amarburg/mascot_project_management/block_diagrams/Visio-IRD_Zed_Dry_Prototype_Block_Diagram.pdf

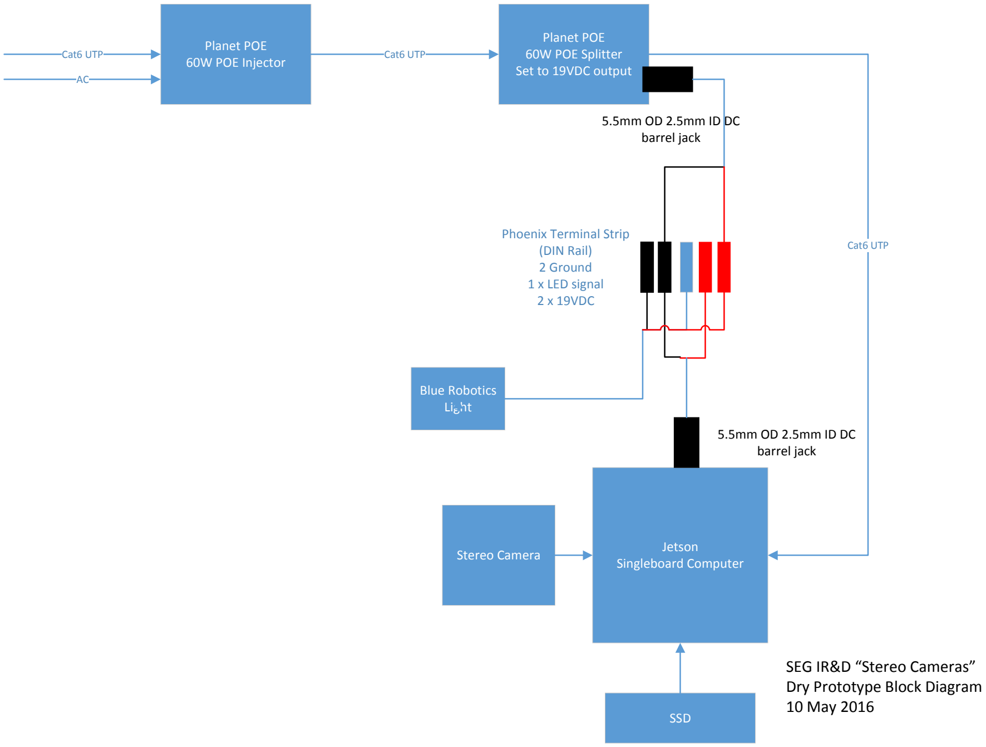
[picture p2: figure]
SEG IR&D “Stereo Cameras” Dry Prototype Block Diagram 10 May 2016; Planet POE 60W POE Injector; Planet POE 60W POE Splitter Set to 19VDC output; Cat6 UTP; Phoenix Terminal Strip (DIN Rail) 2 Ground 1 x LED signal 2 x 19VDC; 5.5mm OD 2.5mm ID DC barrel jack; Jetson Singleboard Computer; SSD; Stereo Camera; Blue Robotics Light
