amarburg/mascot_project_management/images/box_POE-171S.jpg

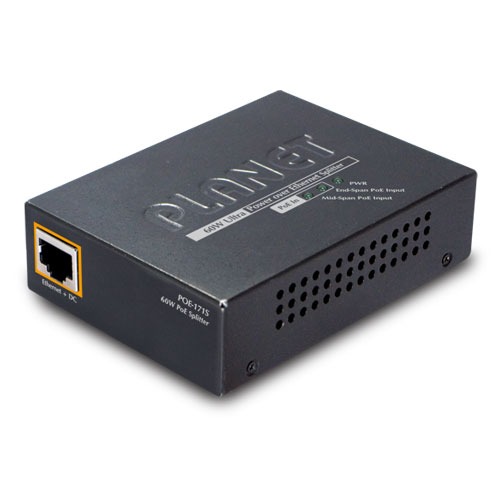
images/box_POE-171S.jpg
