amarburg/mascot_project_management/images/box_POE-172.jpg

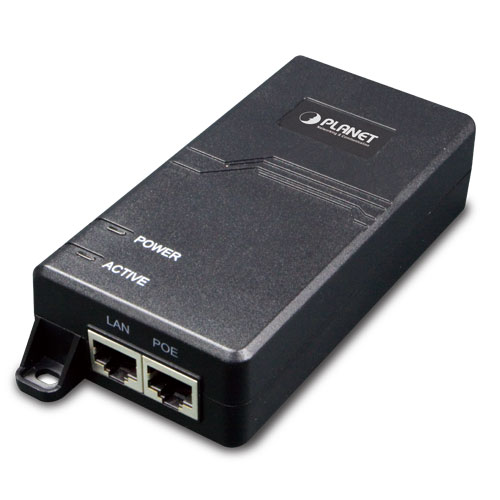
images/box_POE-172.jpg
