amarburg/mascot_project_management/images/DSC_0268.JPG

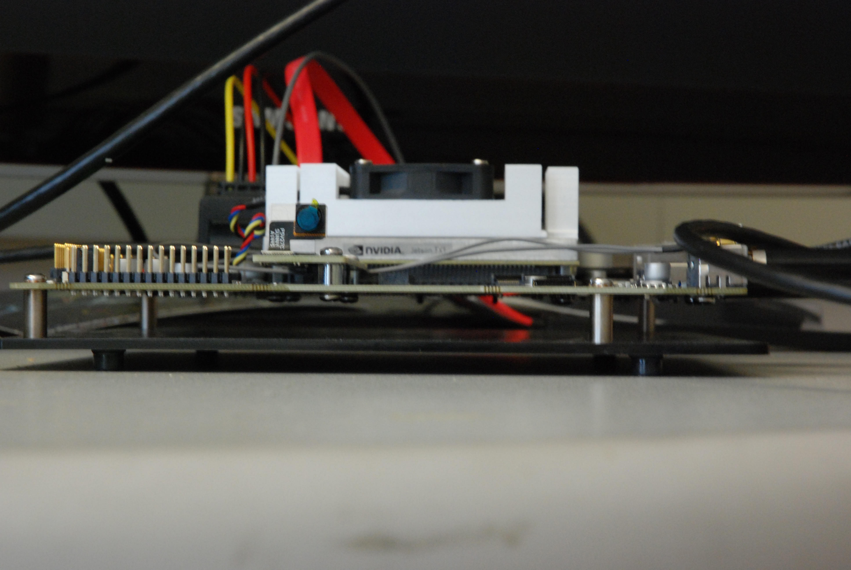
images/DSC_0268.JPG
