amarburg/mascot_project_management/images/DSC_0270.JPG

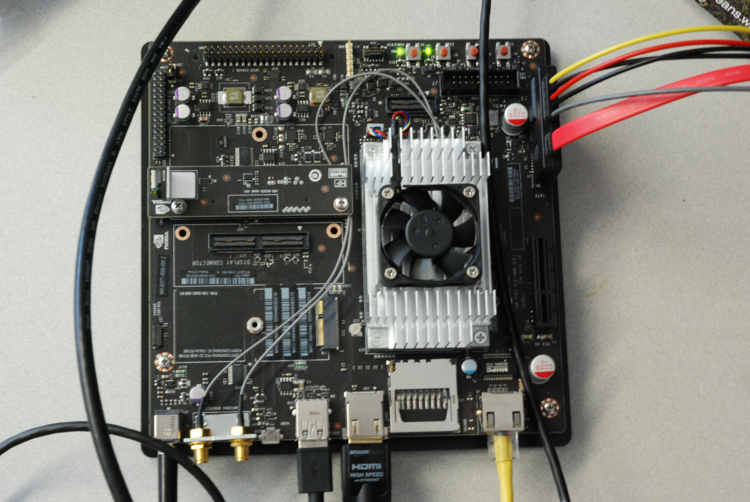
images/DSC_0270.JPG
