amarburg/mascot_project_management/images/Image-1.png

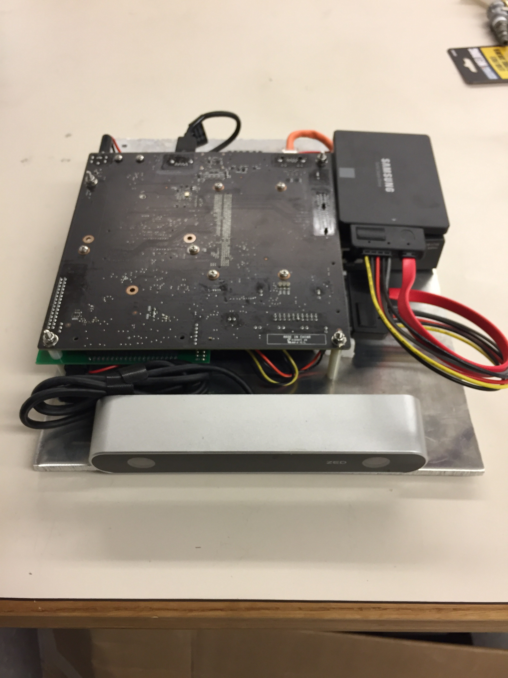
images/Image-1.png
