amarburg/mascot_project_management/images/Image-2.png

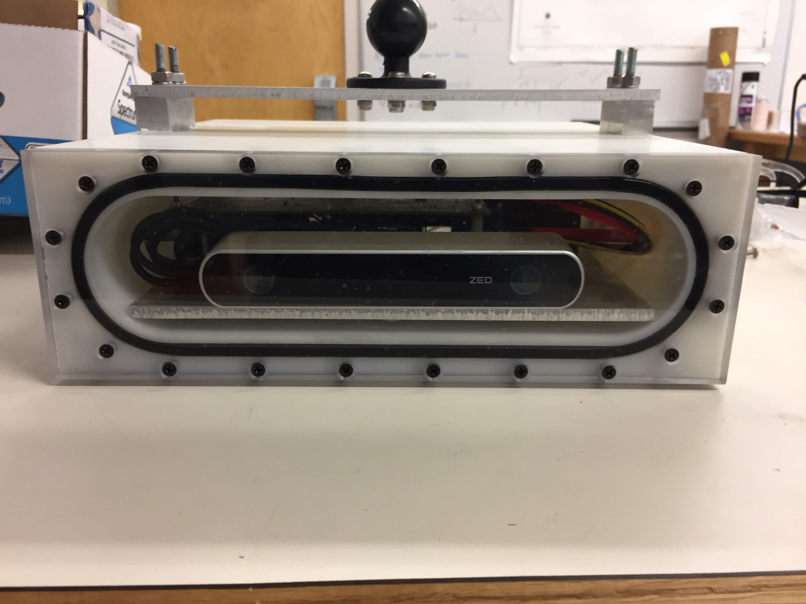
images/Image-2.png
