amarburg/mascot_project_management/images/Image.png

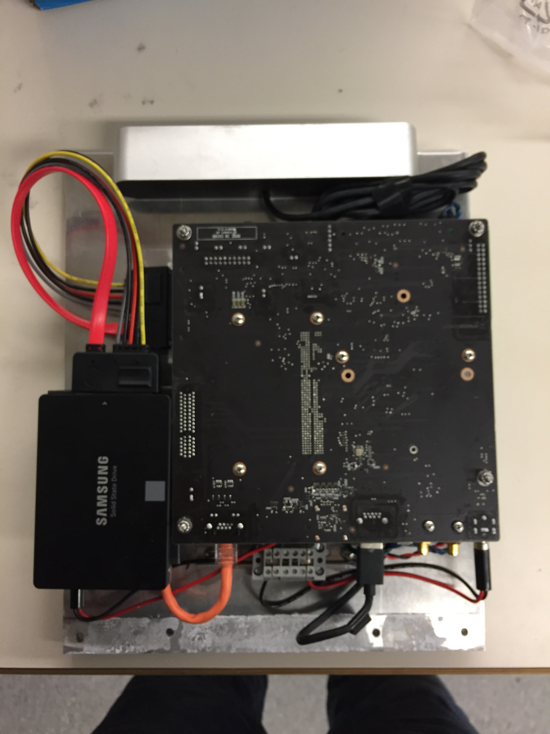
images/Image.png
