amarburg/mascot_project_management/images/IMG_0014.JPG

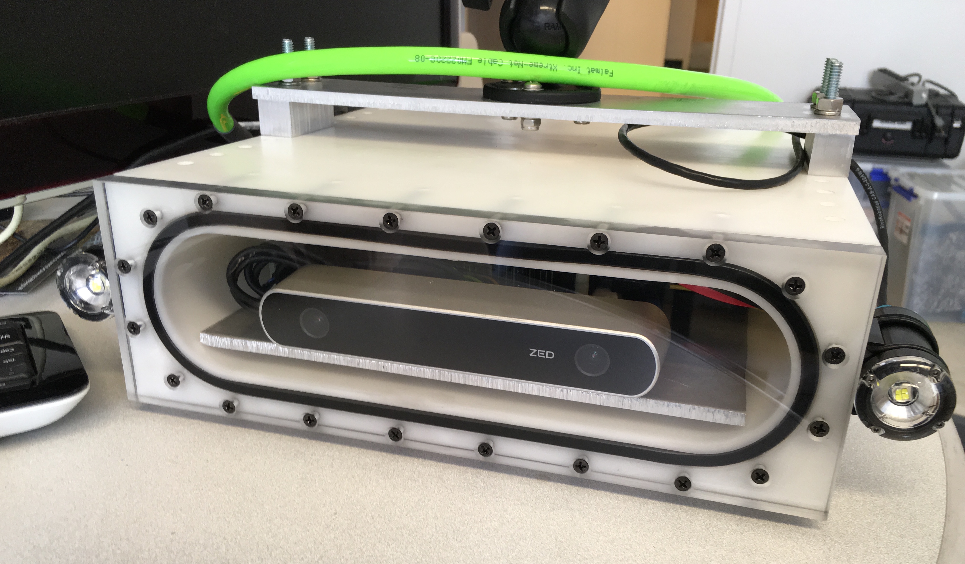
images/IMG_0014.JPG
