amarburg/mascot_project_management/images/jetson_tx1_carrier_board_diagram.png

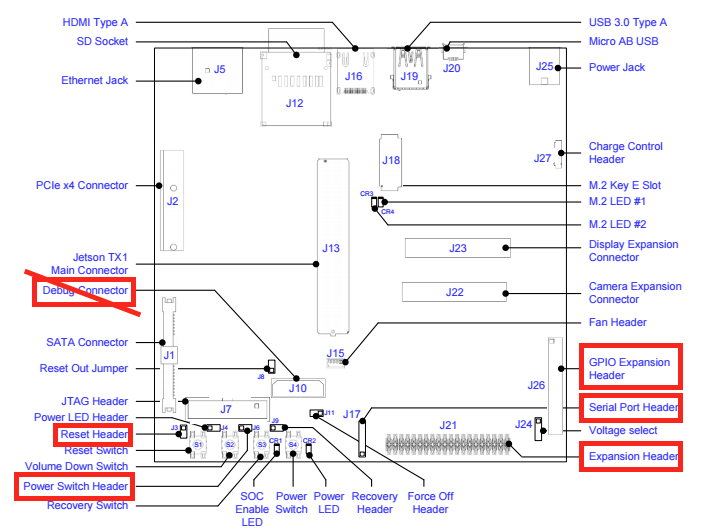
images/jetson_tx1_carrier_board_diagram.png
