amarburg/mascot_project_management/images/left_000455.png

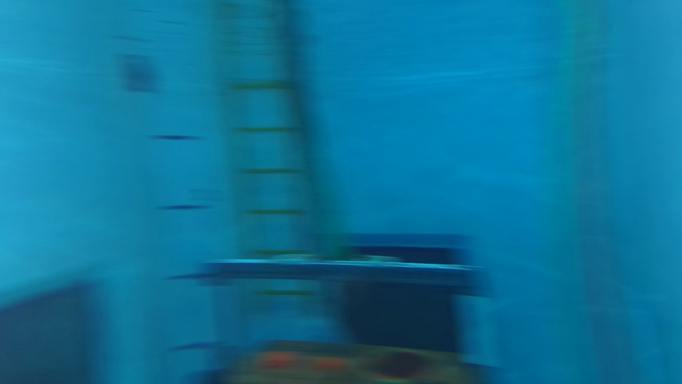
images/left_000455.png
