amarburg/mascot_project_management/images/left_000553.png

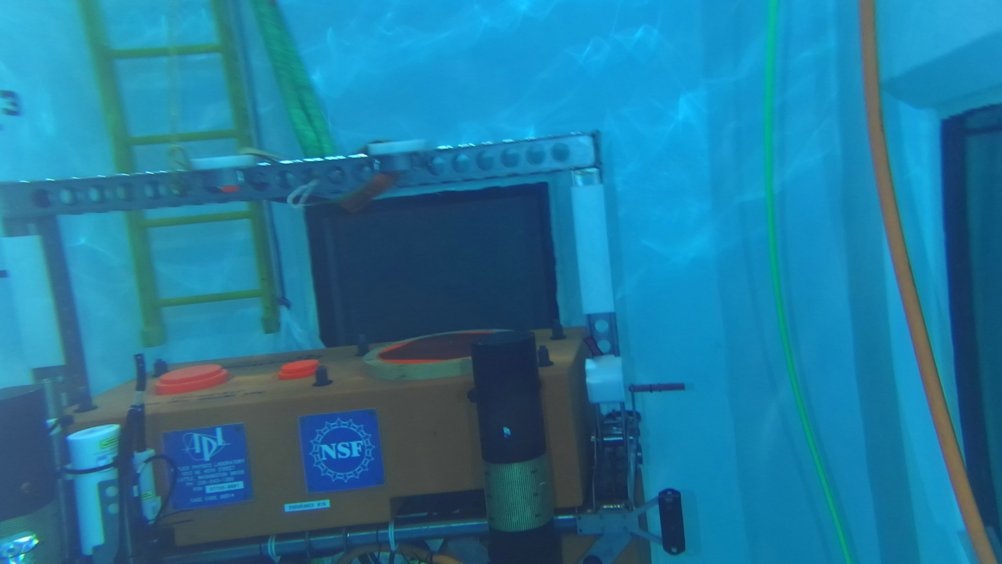
images/left_000553.png
