amarburg/mascot_project_management/images/left_000827.png

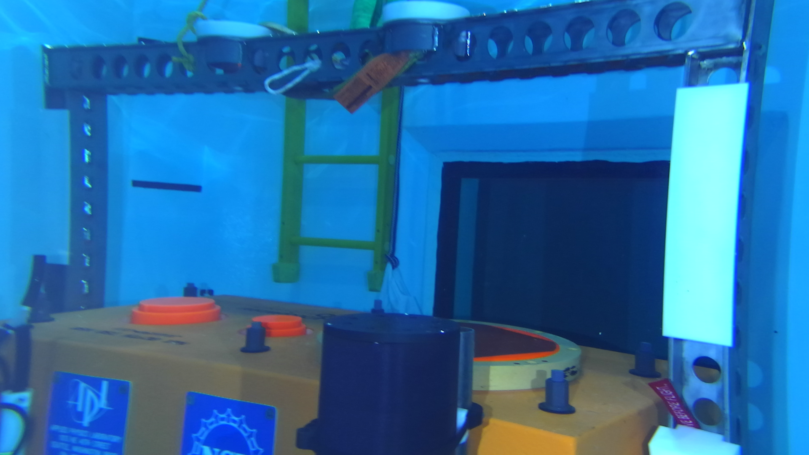
images/left_000827.png
