amarburg/mascot_project_management/images/mascot_pool_2.jpg

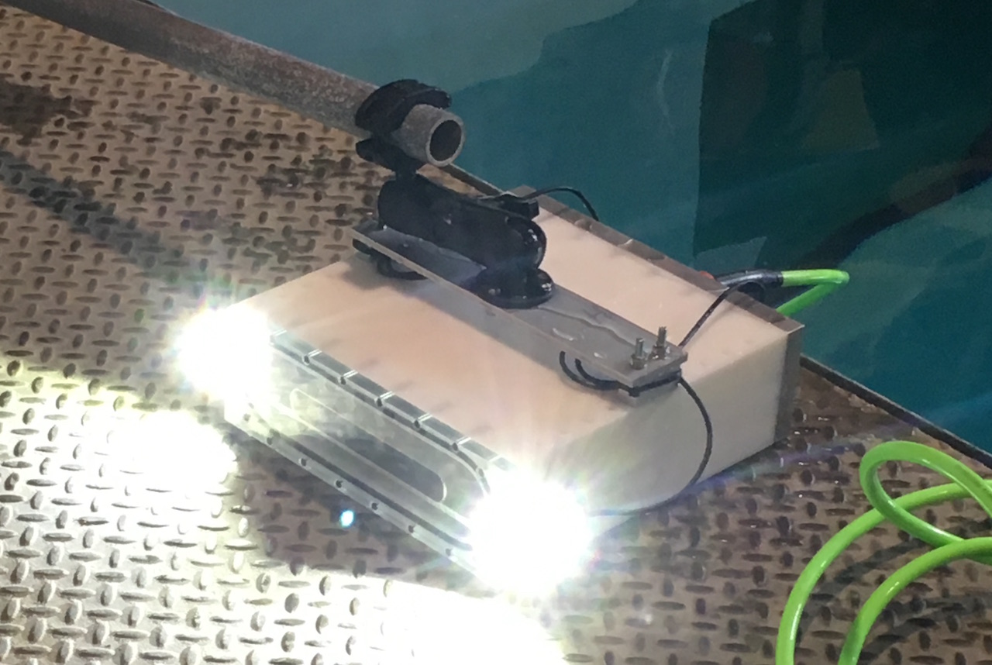
images/mascot_pool_2.jpg
