amarburg/mascot_project_management/images/subconn_8contact_ethernet.png

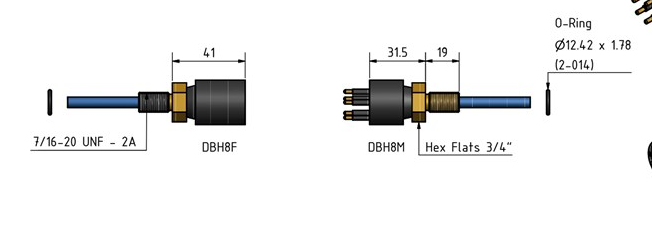
images/subconn_8contact_ethernet.png
