amarburg/mascot_project_management/analysis/jetson_recorder_performance/recorder_stats.csv

HD1080 | 15 |  | 132 | 10.1968 | 411.329
HD1080 | 15 |  | 127 | 10.026 | 435.06
HD1080 | 15 |  | 122 | 10.0097 | 332.228
HD1080 | 15 |  | 131 | 10.0297 | 545.802
HD1080 | 15 |  | 128 | 10.0248 | 419.24
HD1080 | 15 |  | 124 | 10.0132 | 616.994
HD1080 | 15 |  | 132 | 10.0549 | 458.79
HD1080 | 15 |  | 133 | 10.0167 | 166.114
HD1080 | 15 |  | 133 | 10.0279 | 174.024
HD1080 | 15 |  | 135 | 10.0375 | 0
HD1080 | 15 | display | 56 | 10.4556 | 427.15
HD1080 | 15 | display | 53 | 10.0545 | 403.419
HD1080 | 15 | display | 53 | 10.1395 | 411.329
HD1080 | 15 | display | 47 | 10.0291 | 363.868
HD1080 | 15 | display | 50 | 10.0553 | 379.689
HD1080 | 15 | display | 57 | 10.0491 | 371.778
HD1080 | 15 | display | 57 | 10.1477 | 411.329
HD1080 | 15 | display | 56 | 10.0176 | 435.06
HD1080 | 15 | display | 58 | 10.7794 | 419.24
HD1080 | 15 | display | 55 | 10.6297 | 419.24
HD720 | 30 |  | 265 | 10.0144 | 379.69
HD720 | 30 |  | 264 | 10.0016 | 478.128
HD720 | 30 |  | 266 | 10.0225 | 330.471
HD720 | 30 |  | 254 | 10.0074 | 210.939
HD720 | 30 |  | 264 | 10.0207 | 355.08
HD720 | 30 |  | 253 | 10.0333 | 495.706
HD720 | 30 |  | 261 | 10.0161 | 562.504
HD720 | 30 |  | 264 | 10.0217 | 165.235
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
