amarburg/mascot_project_management/block_diagrams/IRD_Zed_Block_Diagram.pdf

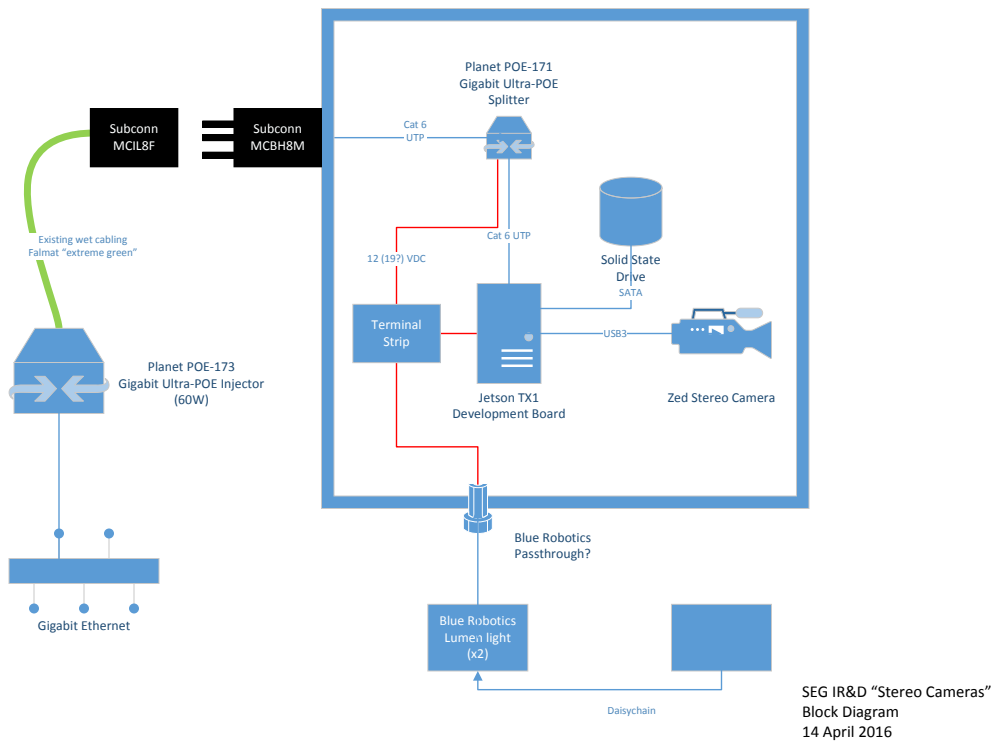
[picture p19: page 1]
12 (19?) VDC; Gigabit Ethernet; Subconn MCIL8F; Cat 6 UTP; Jetson TX1 Development Board; USB3; Terminal Strip; Solid State Drive; SATA; Subconn MCBH8M; Blue Robotics Lumen light (x2); Blue Robotics Passthrough?; Daisychain

Planet POE-171
Gigabit Ultra-POE
Splitter

Existing wet cabling
Falmat “extreme green”

Planet POE-173
Gigabit Ultra-POE Injector

Zed Stereo Camera

SEG IR&D “Stereo Cameras”
Block Diagram
14 April 2016
