amarburg/mascot_project_management/schematic/Companion_Board.brd

## EAGLE design schematic/Companion_Board.brd (2016-05-11, last stored version)

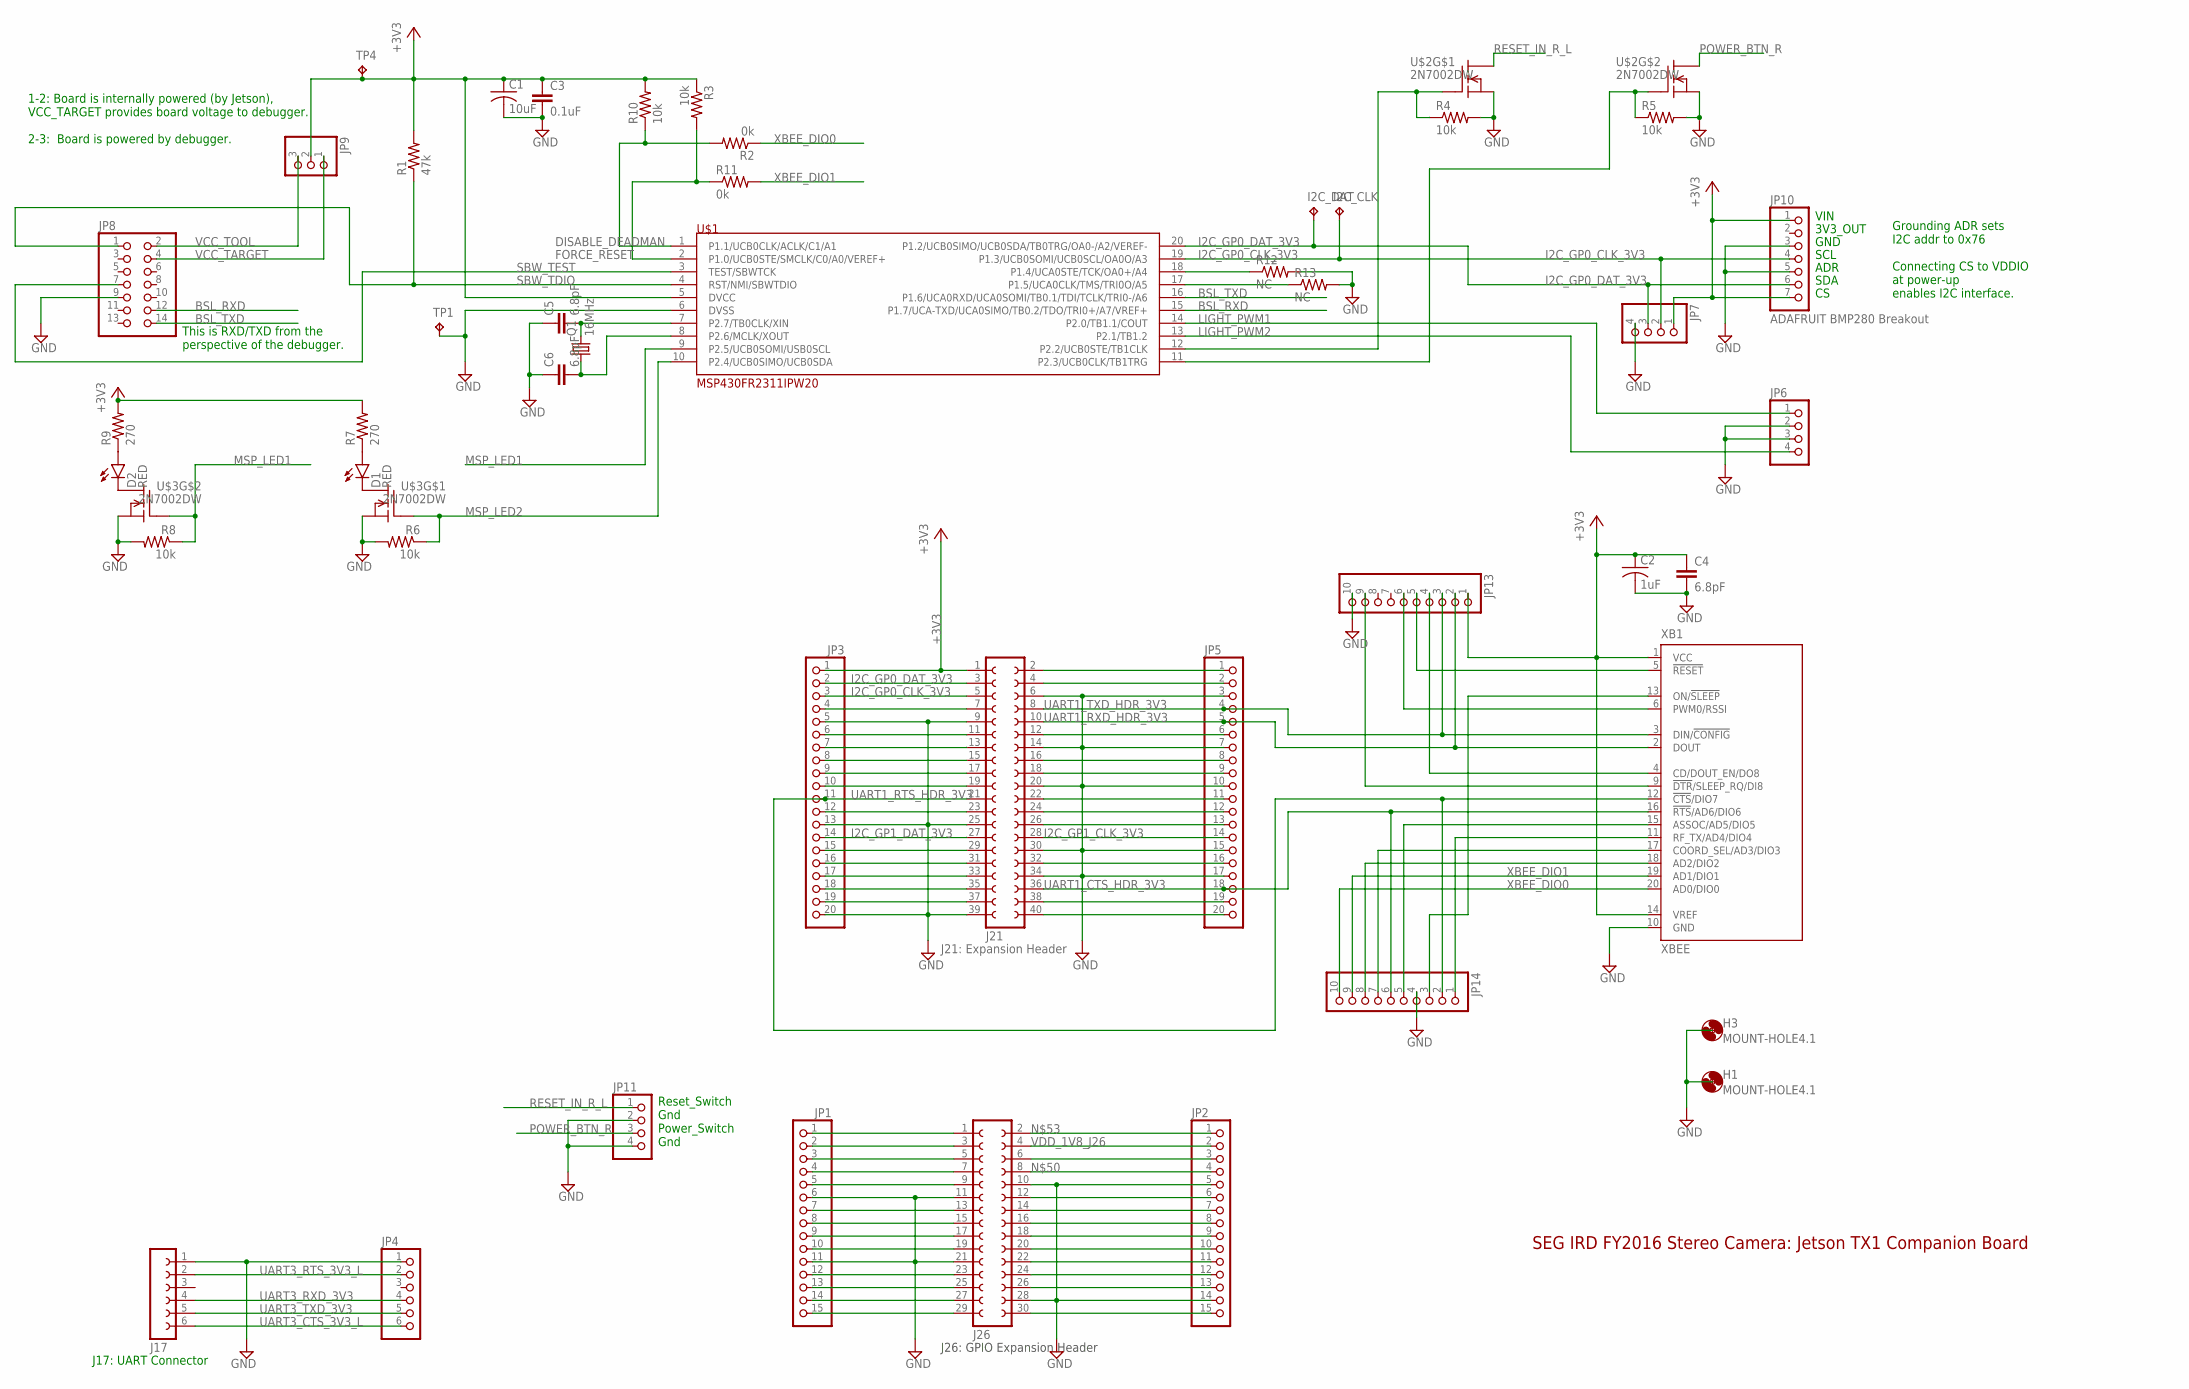
[picture p20: schematic Companion_Board.sch]

Parts:
C1: 10uF; C1206
C2: 1uF; C1206
C3: 0.1uF; C0805
C4, C5, C6: 6.8pF; C0805
D1, D2: RED; LED-1206
H1, H3: MOUNT-HOLE4.1; 4,1
I2C_CLK, I2C_DAT: TPPAD1-13; P1-13
J17: FE06-1; FE06
J21: FE20-2
J26: FE15-2
JP1, JP2: PINHD-1X15; 1X15
JP3, JP5: PINHD-1X20; 1X20
JP4: PINHD-1X6; 1X06
JP6, JP11: PINHD-1X4/90; 1X04/90
JP7: PINHD-1X4; 1X04
JP8: PINHD-2X7; 2X07
JP9: PINHD-1X3; 1X03
JP10: ADAFRUIT BMP280 Breakout; 1X07
JP13, JP14: PINHD-1X10; 1X10
Q1: 16MHz; HC49UP
R1: 47k; R0805
R2, R11: 0k; R0805
R3, R4, R5, R6, R8, R10: 10k; R0805
R7, R9: 270; R0805
R12, R13: NC; R0805
TP1, TP4: TPPAD1-13; P1-13
U$1: MSP430FR2311IPW20; SOP65P640X120-20N
U$2, U$3: 2N7002DW; SOT363
XB1: XBEE

Connections:
+3V3: C1.1, C2.1, C3.1, C4.1, J21.1, JP3.1, JP7.1, JP9.2, JP10.1, JP10.7, JP13.1, R1.2, R3.1, R7.2, R9.2, R10.2, TP4.TP, U$1.5 (DVCC), XB1.1 (VCC), XB1.14 (VREF)
BSL_RXD: JP8.12, U$1.15 (P1.7/UCA-TXD/UCA0SIMO/TB0.2/TDO/TRI0+/A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)
BSL_TXD: JP8.14, U$1.16 (P1.6/UCA0RXD/UCA0SOMI/TB0.1/TDI/TCLK/TR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)
DISABLE_DEADMAN: R2.2, R10.1, U$1.1 (P1.1/UCB0CLK/ACLK/C1/A1)
FORCE_RESET: R3.2, R11.1, U$1.2 (P1.0/UCB0STE/SMCLK/C0/A0/VEREF+)
GND: C1.2, C2.2, C3.2, C4.2, C5.1, C6.1, J17.1, J21.6, J21.9, J21.14, J21.20, J21.25, J21.30, J21.34, J21.39, J26.10, J26.11, J26.21, J26.28, JP1.6, JP1.11, JP2.5, JP2.14, JP3.5, JP3.13, JP3.20, JP4.1, JP5.3, JP5.7, JP5.10, JP5.15, JP5.17, JP6.2, JP6.3, JP7.4, JP8.9, JP10.3, JP10.5, JP11.2, JP11.4, JP13.10, JP14.4, R4.2, R5.2, R6.2, R8.2, R12.2, R13.2, TP1.TP, U$1.6 (DVSS), U$2.1 (S), U$2.4 (S), U$3.1 (S), U$3.4 (S), XB1.10 (GND)
I2C_GP0_CLK_3V3: I2C_CLK.TP, J21.5, JP3.3, JP7.2, JP10.4, U$1.19 (P1.3/UCB0SOMI/UCB0SCL/OA0O/A3)
I2C_GP0_DAT_3V3: I2C_DAT.TP, J21.3, JP3.2, JP7.3, JP10.6, U$1.20 (P1.2/UCB0SIMO/UCB0SDA/TB0TRG/OA0-/A2/VE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)
I2C_GP1_CLK_3V3: J21.28, JP5.14
I2C_GP1_DAT_3V3: J21.27, JP3.14
LIGHT_PWM1: JP6.1, U$1.14 (P2.0/TB1.1/COUT)
LIGHT_PWM2: JP6.4, U$1.13 (P2.1/TB1.2)
MSP_LED1: R8.1, U$1.9 (P2.5/UCB0SOMI/USB0SCL), U$3.5 (G)
MSP_LED2: R6.1, U$1.10 (P2.4/UCB0SIMO/UCB0SDA), U$3.2 (G)
unnamed: J26.1, JP1.1
unnamed: J26.3, JP1.2
unnamed: J26.5, JP1.3
unnamed: J26.7, JP1.4
unnamed: J26.9, JP1.5
unnamed: J26.13, JP1.7
unnamed: J26.15, JP1.8
unnamed: J26.17, JP1.9
unnamed: J26.19, JP1.10
unnamed: J26.23, JP1.12
unnamed: J26.25, JP1.13
unnamed: J26.27, JP1.14
unnamed: J26.29, JP1.15
unnamed: J26.30, JP2.15
unnamed: J26.26, JP2.13
unnamed: J26.24, JP2.12
unnamed: J26.22, JP2.11
unnamed: J26.20, JP2.10
unnamed: J26.18, JP2.9
unnamed: J26.16, JP2.8
unnamed: J26.14, JP2.7
unnamed: J26.12, JP2.6
unnamed: R12.1, U$1.18 (P1.4/UCA0STE/TCK/OA0+/A4)
unnamed: J21.7, JP3.4
unnamed: J26.6, JP2.3
unnamed: J21.11, JP3.6
unnamed: J21.13, JP3.7
unnamed: J21.15, JP3.8
unnamed: J21.19, JP3.10
unnamed: J21.23, JP3.12
unnamed: R13.1, U$1.17 (P1.5/UCA0CLK/TMS/TRI0O/A5)
unnamed: J21.29, JP3.15
unnamed: J21.31, JP3.16
unnamed: J21.33, JP3.17
unnamed: J21.35, JP3.18
unnamed: J21.37, JP3.19
unnamed: C5.2, Q1.2, U$1.7 (P2.7/TB0CLK/XIN)
unnamed: J21.12, JP5.6
unnamed: J21.16, JP5.8
unnamed: J21.18, JP5.9
unnamed: J21.22, JP5.11
unnamed: J21.24, JP5.12
unnamed: C6.2, Q1.1, U$1.8 (P2.6/MCLK/XOUT)
unnamed: D1.C, U$3.6 (D)
unnamed: J21.32, JP5.16
unnamed: J21.4, JP5.2
unnamed: J21.38, JP5.19
unnamed: J21.40, JP5.20
unnamed: J21.17, JP3.9
unnamed: J26.8, JP2.4
unnamed: J26.2, JP2.1
unnamed: R4.1, U$1.12 (P2.2/UCB0STE/TB1CLK), U$2.2 (G)
unnamed: R5.1, U$1.11 (P2.3/UCB0CLK/TB1TRG), U$2.5 (G)
unnamed: D2.C, U$3.3 (D)
unnamed: JP13.5, XB1.5 (!RESET)
unnamed: JP13.6, XB1.6 (PWM0/RSSI)
unnamed: JP13.4, XB1.4 (CD/DOUT_EN/DO8)
unnamed: JP13.9, XB1.9 (!DTR!/SLEEP_RQ/DI8)
unnamed: JP14.3, XB1.13 (ON/!SLEEP)
unnamed: JP14.5, XB1.15 (ASSOC/AD5/DIO5)
unnamed: JP14.1, XB1.11 (RF_TX/AD4/DIO4)
unnamed: JP14.7, XB1.17 (COORD_SEL/AD3/DIO3)
unnamed: JP14.8, XB1.18 (AD2/DIO2)
unnamed: D1.A, R7.1
unnamed: D2.A, R9.1
POWER_BTN_R: JP11.3, U$2.3 (D)
RESET_IN_R_L: JP11.1, U$2.6 (D)
SBW_TDIO: JP8.1, R1.1, U$1.4 (RST/NMI/SBWTDIO)
SBW_TEST: JP8.7, U$1.3 (TEST/SBWTCK)
SPI_CS1_3V3: J21.26, JP5.13
UART1_CTS_HDR_3V3: J21.36, JP5.18, JP14.6, XB1.16 (!RTS!/AD6/DIO6)
UART1_RTS_HDR_3V3: J21.21, JP3.11, JP14.2, XB1.12 (!CTS!/DIO7)
UART1_RXD_HDR_3V3: J21.10, JP5.5, JP13.2, XB1.2 (DOUT)
UART1_TXD_HDR_3V3: J21.8, JP5.4, JP13.3, XB1.3 (DIN/!CONFIG)
UART3_CTS_3V3_L: J17.6, JP4.6
UART3_RTS_3V3_L: J17.2, JP4.2
UART3_RXD_3V3: J17.4, JP4.4
UART3_TXD_3V3: J17.5, JP4.5
VCC_TARGET: JP8.4, JP9.1
VCC_TOOL: JP8.2, JP9.3
VDD_1V8_J26: J26.4, JP2.2
VDD_5V0_IO_SYS: J21.2, JP5.1
XBEE_DIO0: JP14.10, R2.1, XB1.20 (AD0/DIO0)
XBEE_DIO1: JP14.9, R11.2, XB1.19 (AD1/DIO1)

Notes on the sheet:
J17: UART Connector
J26: GPIO Expansion Header
J21: Expansion Header
3V3_OUT
GND
SCL
ADR
SDA
Grounding ADR sets I2C addr to 0x76 Connecting CS to VDDIO at power-up enables I2C interface.
SEG IRD FY2016 Stereo Camera: Jetson TX1 Companion Board
1-2: Board is internally powered (by Jetson), VCC_TARGET provides board voltage to debugger. 2-3: Board is powered by debugger.
This is RXD/TXD from the perspective of the debugger.
Reset_Switch Gnd Power_Switch Gnd
VIN

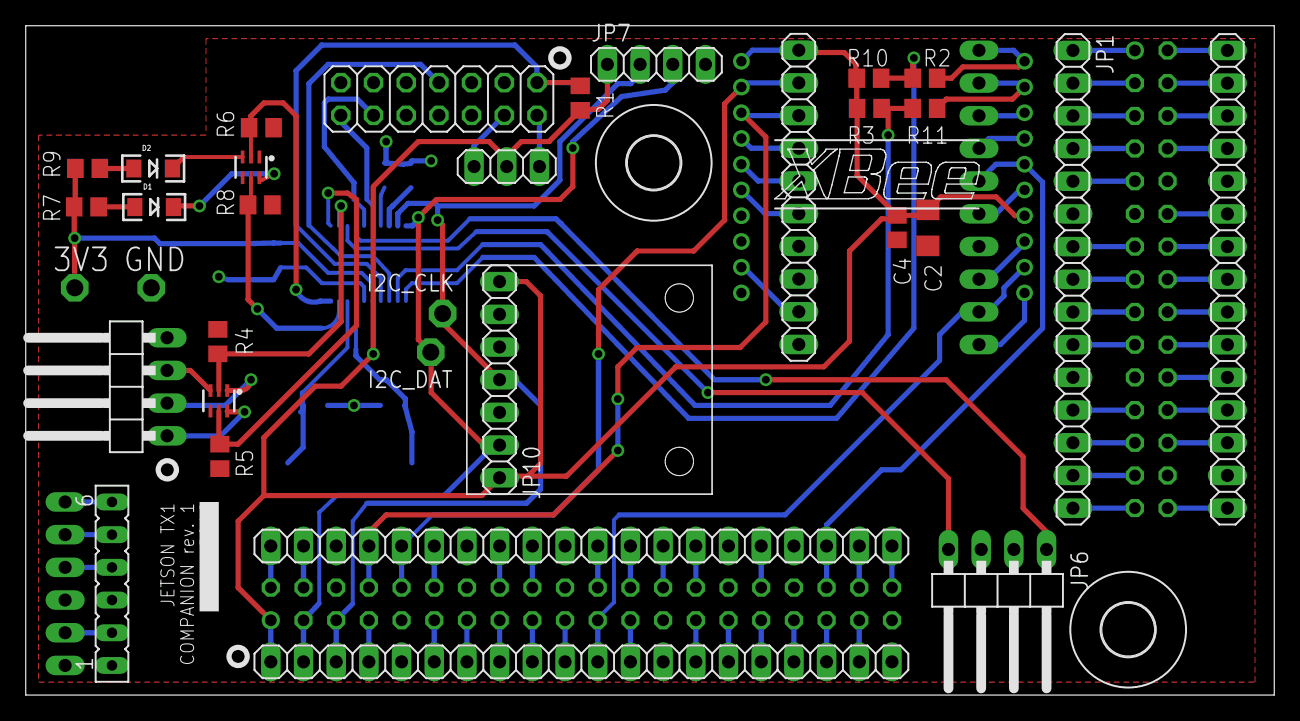
[picture p21: board Companion_Board.brd from above]

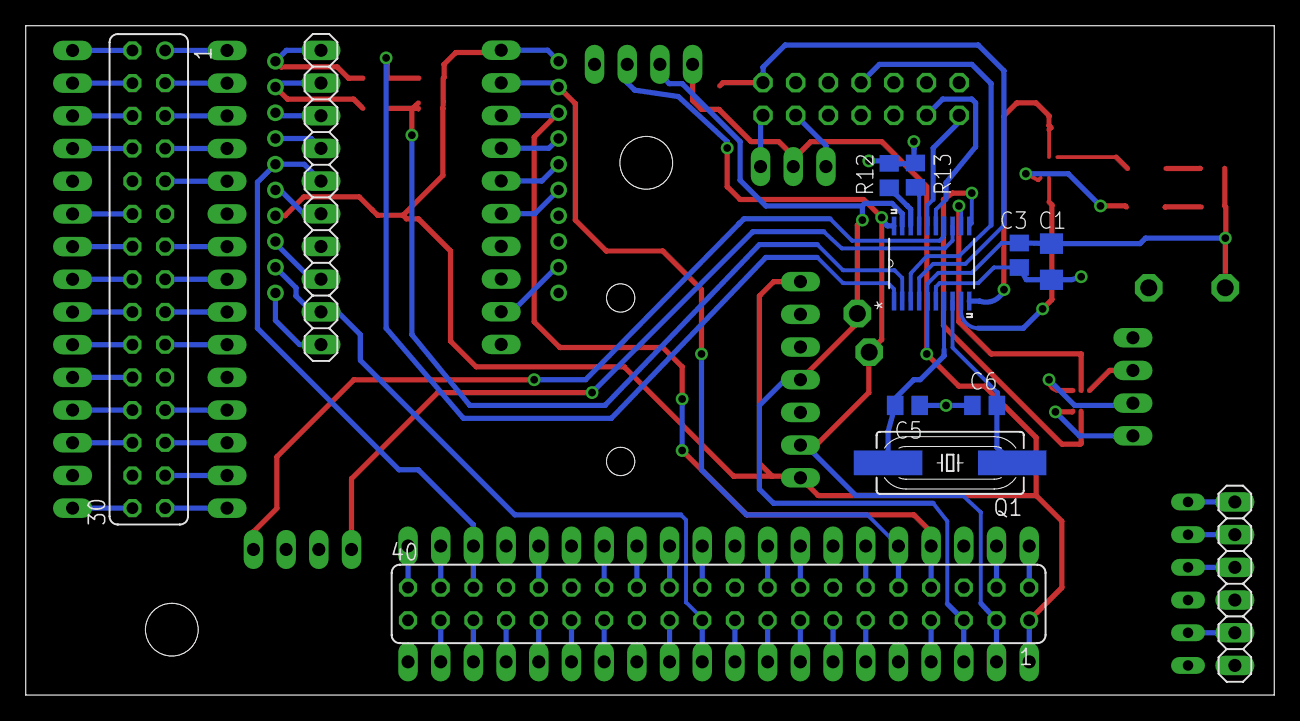
[picture p22: board Companion_Board.brd from below]

Board: 2 copper layers, 97.0 x 52.0 mm, 48 parts (12 on the bottom side), 98 nets.
