amarburg/mascot_project_management/(commit log)

2016-04-28 Initial commit of companion board.
    [Debug_Port.sch]
2016-04-29 Iteration on companion board.
    [Debug_Port.sch]
2016-05-02 Changed name to Companion_Board
    [Companion_Board.sch]
2016-05-02 Removing "Debug_Port.sch", as it's been renamed.
    [Debug_Port.sch]
2016-05-03 Working on Companion board and README.
    [Companion_Board.sch]
2016-05-04 Consolidating footprints for companion board.
    [Companion_Board.sch]
2016-05-04 Restructured, moved schematics into its own subdir, created firmware directory.
    [Companion_Board.sch]
2016-05-04 Updated spec and schematic with pinheaders for reset and power.
    [Companion_Board.sch]
2016-05-04 Added picture of Jetson.
2016-05-04 Added mounting holes.
    [Companion_Board.sch]
2016-05-06 Working on companion board layout.
    [Companion_Board.brd, Companion_Board.sch]
2016-05-06 Removed debug connector, now have parts laid out.
    [Companion_Board.brd, Companion_Board.sch]
2016-05-06 One iteration on board layout.
    [Companion_Board.brd]
2016-05-06 First draft of board layout.
    [Companion_Board.brd]
2016-05-06 Some corrections to layout.
    [Companion_Board.brd, Companion_Board.sch]
2016-05-10 Pre-production iteration on companion board, including BOM.
    [Bill_of_materials.xlsx, Companion_Board.brd, Companion_Board.sch]
2016-05-11 Updated gerbers.
    [Companion_Board.brd]
2016-05-11 Discovered a few non-connected nets.
    [Companion_Board.brd, Companion_Board.sch]
2016-05-11 Updated schematic with missin serial comms traces to XBee and generated finalized Gerbers.
    [Companion_Board.brd, Companion_Board.sch]
2016-05-11 Added driver for LEDs.
2016-05-11 Updated schematic based on feedback from FreeDFM
    [Companion_Board.brd]
2016-05-26 Watchdog timer test working.
2016-05-27 Basic timer test now working.
2016-05-27 Improved on basic timer loop.
2016-05-31 Successfully starting Jetson with MSP430.
2016-05-31 Have basic I2C slave mode working.
2016-06-01 Successful PWM to lights and I2C->PWM connection.
2016-06-02 Updated README with current status rel to specification.
2016-07-29 Moved jetson temperature and recorder performance into the mascot repo.
    [recorder_stats.csv]
2016-07-29 Folded the jetson_common repo into the mascot repo.
2016-10-26 Split the monolithic repo into separate repos.
    [Bill_of_materials.xlsx, Companion_Board.brd, Companion_Board.sch]
2016-10-26 Added bill of materials for EC002 from the Google Drive.
    [EC002_Bill_of_materials.csv]
2016-10-26 Changed permissions on a couple of images.
